augustocrmattos/PQDB-Hardware/PQDB-Mini-HW-Kicad/Fabricação/BOM.pdf

Reference | Value | Footprint
R406 | Resistor 220 Ohm 5% SMD | 0805
R312 | Resistor 10K 5% SMD | 0805
R403 | Resistor 10K 5% SMD | 0805
R404 | Resistor 10K 5% SMD | 0805
R402 | Resistor 10K 5% SMD | 0805
R201 | Resistor 10K 5% SMD | 0805
R311 | Resistor 10K 5% SMD | 0805
R310 | Resistor 10K 5% SMD | 0805
R309 | Resistor 10K 5% SMD | 0805
R202 | Resistor 10K 5% SMD | 0805
R401 | Resistor 10K 5% SMD | 0805
R102 | Resistor 10K 5% SMD | 0805
R701 | Resistor 10K 5% SMD | 0805
R702 | Resistor 10K 5% SMD | 0805
R101 | Resistor 10K 5% SMD | 0805
R405 | Resistor 10K 5% SMD | 0805
R703 | Resistor 10K 5% SMD | 0805
C701 | Capacitor cerâmico 25V 10nF SMD | 0805
R304 | Resistor 1k 5% SMD | 0805
R303 | Resistor 1k 5% SMD | 0805
R302 | Resistor 1k 5% SMD | 0805
R301 | Resistor 1k 5% SMD | 0805
R308 | Resistor 1k 5% SMD | 0805
R307 | Resistor 1k 5% SMD | 0805
R306 | Resistor 1k 5% SMD | 0805
R305 | Resistor 1k 5% SMD | 0805
R501 | Resistor 1k 5% SMD | 0805
R502 | Resistor 1k 5% SMD | 0805
R503 | Resistor 1k 5% SMD | 0805
R103 | Resistor 1k 5% SMD | 0805
R104 | Resistor 1k 5% SMD | 0805
R105 | Resistor 1k 5% SMD | 0805
R106 | Resistor 1k 5% SMD | 0805
X701 | Cristal Axial 32,768 KHz | TC2x6
U401 | Display Nokia 5110
U601 | 74HC595 | SOIC-16
RGB501 | LED RGB 5mm | 4 Pinos
Q304 | BC847 | SOT-23
Q303 | BC847 | SOT-23
Q302 | BC847 | SOT-23
Q301 | BC847 | SOT-23
Q201 | BC847 | SOT-23
Q101 | BC847 | SOT-23
Q102 | BC847 | SOT-23
SW104 | Chave Tactil 6x6x4,3 180 graus 4 Terminais PTH | 6x6x4,3mm
SW106 | Chave Tactil 6x6x4,3 180 graus 4 Terminais PTH | 6x6x4,3mm
SW108 | Chave Tactil 6x6x4,3 180 graus 4 Terminais PTH | 6x6x4,3mm
SW110 | Chave Tactil 6x6x4,3 180 graus 4 Terminais PTH | 6x6x4,3mm
SW102 | Chave Tactil 6x6x4,3 180 graus 4 Terminais PTH | 6x6x4,3mm

SW103 | Chave Tactil 6x6x4,3 180 graus 4 Terminais PTH | 6x6x4,3mm
SW105 | Chave Tactil 6x6x4,3 180 graus 4 Terminais PTH | 6x6x4,3mm
SW107 | Chave Tactil 6x6x4,3 180 graus 4 Terminais PTH | 6x6x4,3mm
SW109 | Chave Tactil 6x6x4,3 180 graus 4 Terminais PTH | 6x6x4,3mm
SW101 | Chave Tactil 6x6x4,3 180 graus 4 Terminais PTH | 6x6x4,3mm
BZ201 | Buzzer 5V | Espaçamento 7,6mm
D102 | LL4148 | MiniMELF
D104 | LL4148 | MiniMELF
D106 | LL4148 | MiniMELF
D108 | LL4148 | MiniMELF
D110 | LL4148 | MiniMELF
D101 | LL4148 | MiniMELF
D103 | LL4148 | MiniMELF
D105 | LL4148 | MiniMELF
D107 | LL4148 | MiniMELF
D109 | LL4148 | MiniMELF
U701 | DS1307Z | SOIC-8
U301 | Display 7 segmentos 4 digitos KW4-361
LDR201 | LDR 5mm 2 terminais
U201 | LM35 | TO-92
RV201 | Potenciômetro duplo 10K | Espaçamento 5mm
RV202 | Potenciômetro duplo 10K | Espaçamento 5mm
SHIELD801 | Barra de pinos 1x40 20mm | Espaçamento 2,54mm
