augustocrmattos/PQDB-Hardware/PQDB-HW-Kicad/fabricação/BOM.pdf

Reference | Value | Footprint
R312 | Resistor 1/8W 10K PTH | CR25
R201 | Resistor 1/8W 10K PTH | CR25
R311 | Resistor 1/8W 10K PTH | CR25
R310 | Resistor 1/8W 10K PTH | CR25
R309 | Resistor 1/8W 10K PTH | CR25
R202 | Resistor 1/8W 10K PTH | CR25
R102 | Resistor 1/8W 10K PTH | CR25
R701 | Resistor 1/8W 10K PTH | CR25
R702 | Resistor 1/8W 10K PTH | CR25
R101 | Resistor 1/8W 10K PTH | CR25
C701 | Capacitor cerâmico 25V 10nF PTH | 5mm
R407 | Resistor 1/8W 1K PTH | CR25
R408 | Resistor 1/8W 1K PTH | CR25
R406 | Resistor 1/8W 1K PTH | CR25
R304 | Resistor 1/8W 1K PTH | CR25
R303 | Resistor 1/8W 1K PTH | CR25
R302 | Resistor 1/8W 1K PTH | CR25
R301 | Resistor 1/8W 1K PTH | CR25
R308 | Resistor 1/8W 1K PTH | CR25
R307 | Resistor 1/8W 1K PTH | CR25
R306 | Resistor 1/8W 1K PTH | CR25
R305 | Resistor 1/8W 1K PTH | CR25
R401 | Resistor 1/8W 1K PTH | CR25
R501 | Resistor 1/8W 1K PTH | CR25
R502 | Resistor 1/8W 1K PTH | CR25
R503 | Resistor 1/8W 1K PTH | CR25
R103 | Resistor 1/8W 1K PTH | CR25
R105 | Resistor 1/8W 1K PTH | CR25
R106 | Resistor 1/8W 1K PTH | CR25
R104 | Resistor 1/8W 1K PTH | CR25
X701 | Cristal Axial 32,768 KHz | TC2x6
U601 | 74HC595 | DIP-16
RGB501 | LED RGB 5mm | 4 Pinos
Q304 | BC547 | TO-92
Q303 | BC547 | TO-92
Q302 | BC547 | TO-92
Q301 | BC547 | TO-92
Q201 | BC547 | TO-92
Q101 | BC547 | TO-92
Q102 | BC547 | TO-92
SW103 | Chave Tactil 6x6x4,3 180 graus 4 Terminais PTH | 6x6x4,3mm
SW105 | Chave Tactil 6x6x4,3 180 graus 4 Terminais PTH | 6x6x4,3mm
SW107 | Chave Tactil 6x6x4,3 180 graus 4 Terminais PTH | 6x6x4,3mm
SW109 | Chave Tactil 6x6x4,3 180 graus 4 Terminais PTH | 6x6x4,3mm
SW101 | Chave Tactil 6x6x4,3 180 graus 4 Terminais PTH | 6x6x4,3mm
SW104 | Chave Tactil 6x6x4,3 180 graus 4 Terminais PTH | 6x6x4,3mm
SW106 | Chave Tactil 6x6x4,3 180 graus 4 Terminais PTH | 6x6x4,3mm
SW108 | Chave Tactil 6x6x4,3 180 graus 4 Terminais PTH | 6x6x4,3mm
SW110 | Chave Tactil 6x6x4,3 180 graus 4 Terminais PTH | 6x6x4,3mm

SW102 | Chave Tactil 6x6x4,3 180 graus 4 Terminais PTH | 6x6x4,3mm
BZ201 | Buzzer 5V | Espaçamento 7,6mm
BT701 | Suporte para bateria CR2032
D101 | 1N4148 | DO-35
D103 | 1N4148 | DO-35
D105 | 1N4148 | DO-35
D107 | 1N4148 | DO-35
D109 | 1N4148 | DO-35
D102 | 1N4148 | DO-35
D104 | 1N4148 | DO-35
D106 | 1N4148 | DO-35
D108 | 1N4148 | DO-35
D110 | 1N4148 | DO-35
U401 | DISPLAY LCD JHD162A
U701 | DS1307Z | DIP-8
U301 | Display 7 segmentos 4 digitos KW4-361
LDR201 | LDR 5mm 2 terminais
U201 | LM35 | TO-92
RV401 | Potenciômetro duplo 10K | Espaçamento 5mm
RV201 | Potenciômetro duplo 10K | Espaçamento 5mm
SHIELD801 | Barra de pinos 1x40 20mm | Espaçamento 2,54mm
