augustocrmattos/PQDB-Hardware/Montagem Mini SMD.pdf

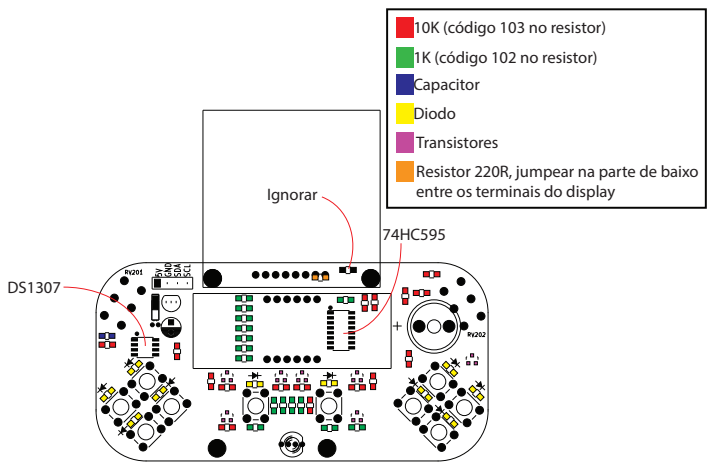
[picture p37: page 1]
Ignorar; entre os terminais do display

10K (código 103 no resistor)
1K (código 102 no resistor)
Capacitor
Diodo
Transistores
Resistor 220R, jumpear na parte de baixo
