augustocrmattos/PQDB-Hardware/PQDB-HW-Kicad/fabricação/Base-F.SilkS.pdf

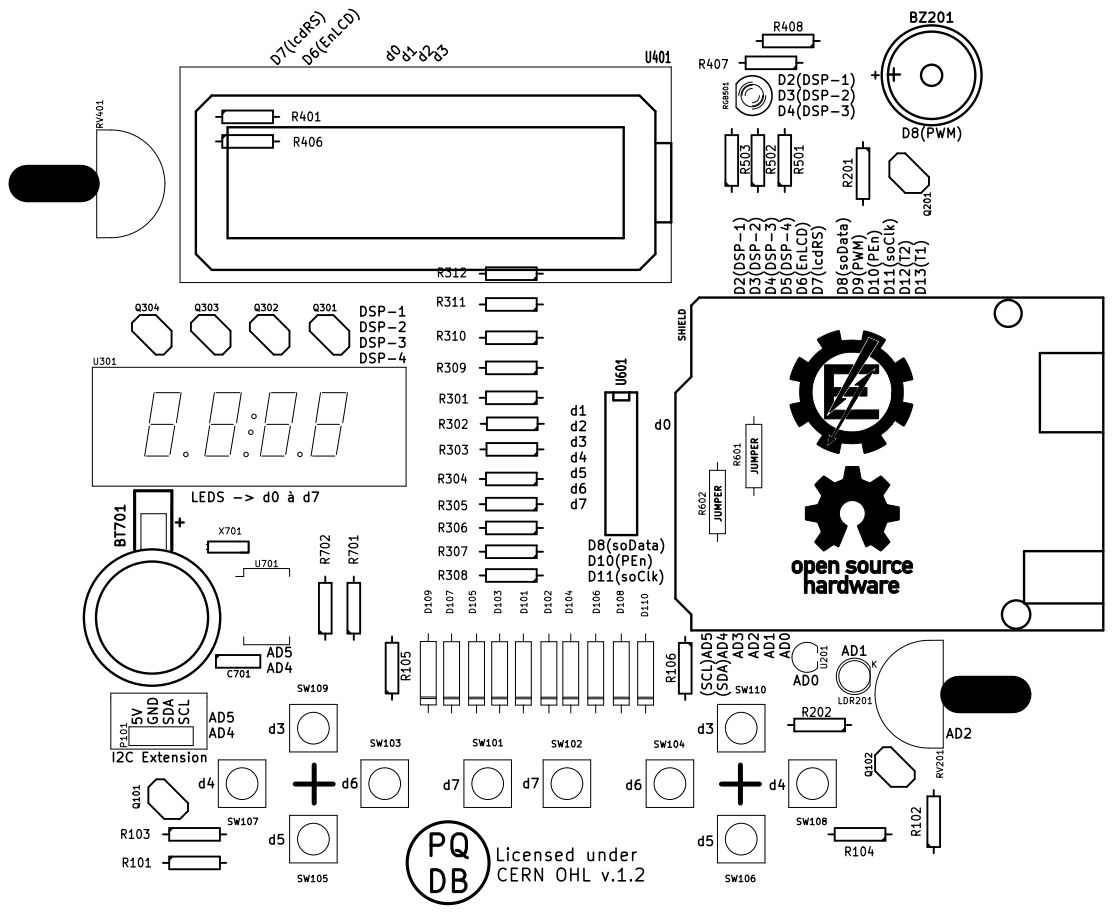
[picture p38: page 1]
