augustocrmattos/PQDB-Hardware/PQDB-Mini-HW-Kicad/Fabricação/Base-B.Cu.pdf

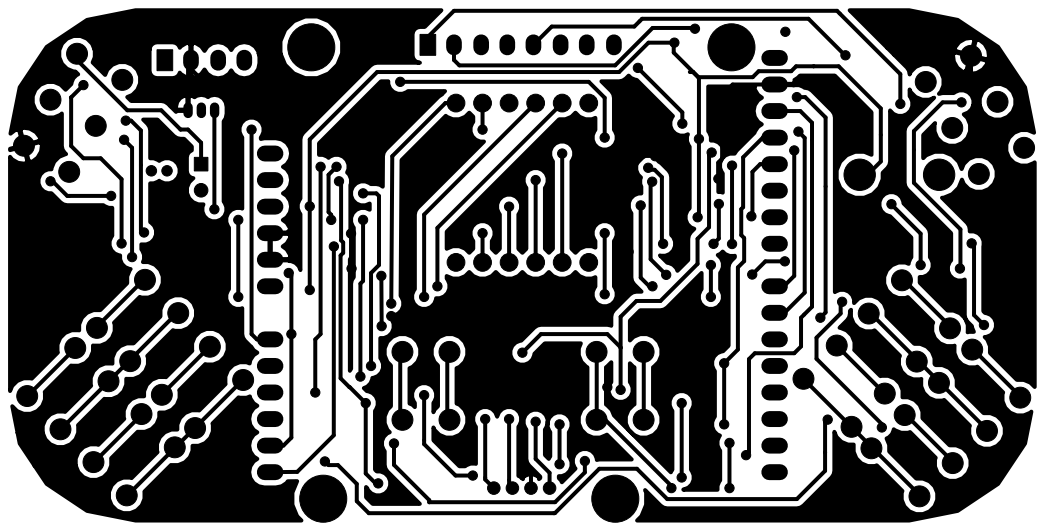
[picture p39: page 1]
