augustocrmattos/PQDB-Hardware/PQDB-Mini-HW-Kicad/Fabricação/Base-B.Mask.pdf

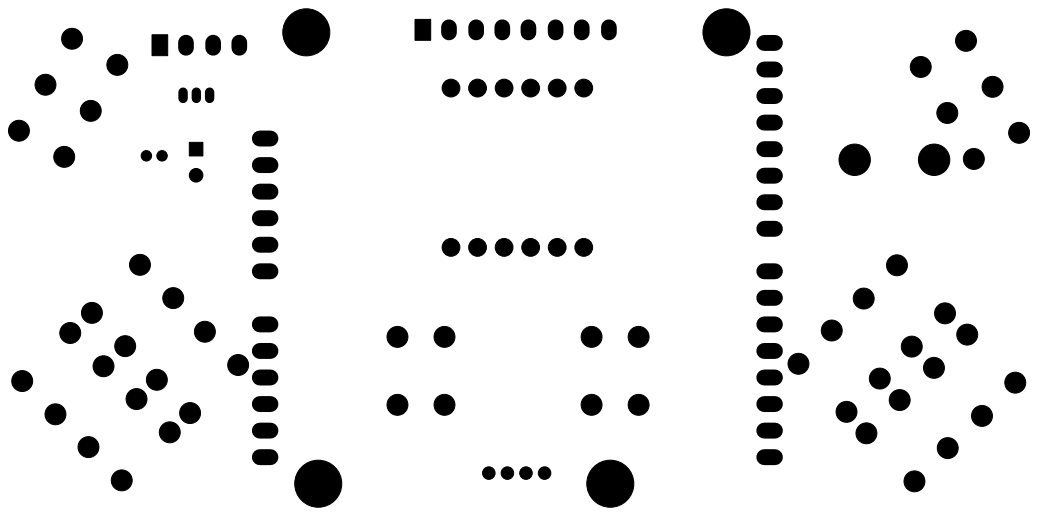
[picture p40: page 1]
