augustocrmattos/PQDB-Hardware/PQDB-Mini-HW-Kicad/Fabricação/Base-Edge.Cuts.pdf

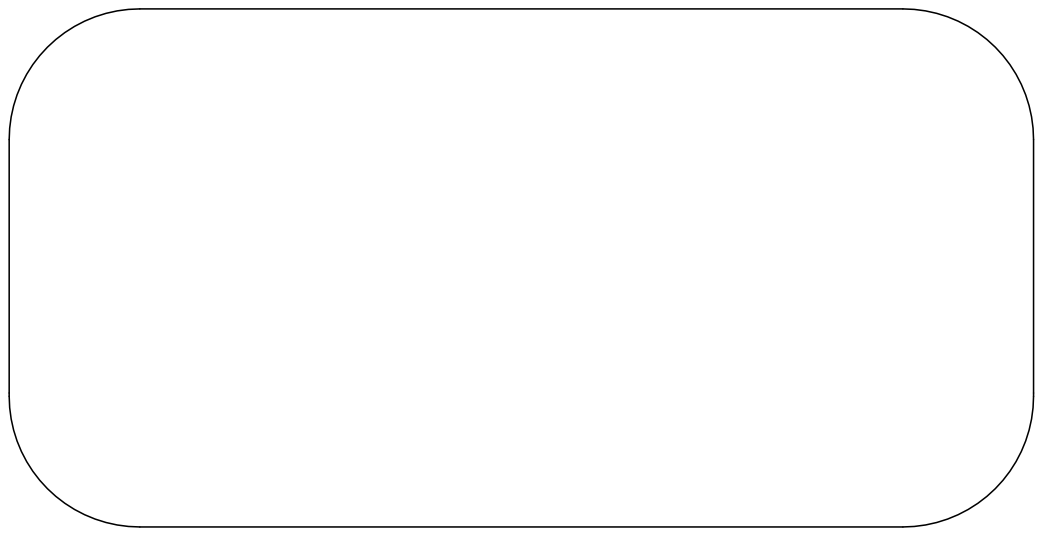
[picture p41: page 1]
