augustocrmattos/PQDB-Hardware/PQDB-Mini-HW-Kicad/Fabricação/Base-F.Cu.pdf

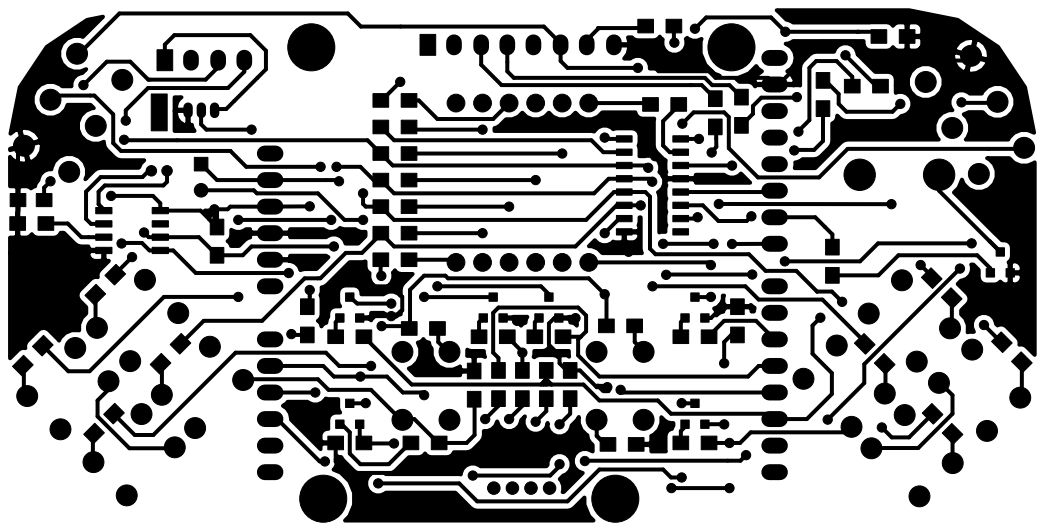
[picture p42: page 1]
