augustocrmattos/PQDB-Hardware/PQDB-Mini-HW-Kicad/Fabricação/Base-F.Mask.pdf

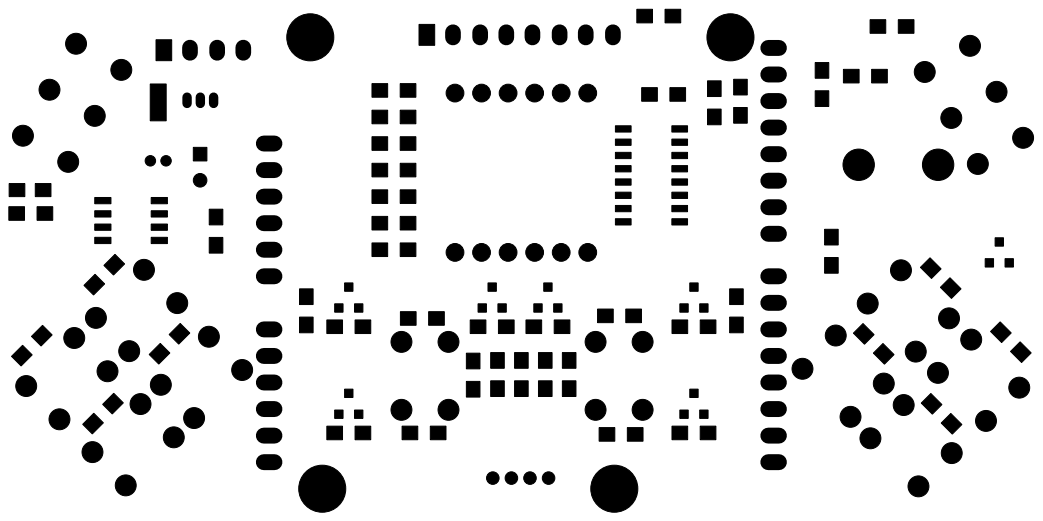
[picture p43: page 1]
