augustocrmattos/PQDB-Hardware/PQDB-Mini-HW-Kicad/Fabricação/Base-F.SilkS.pdf

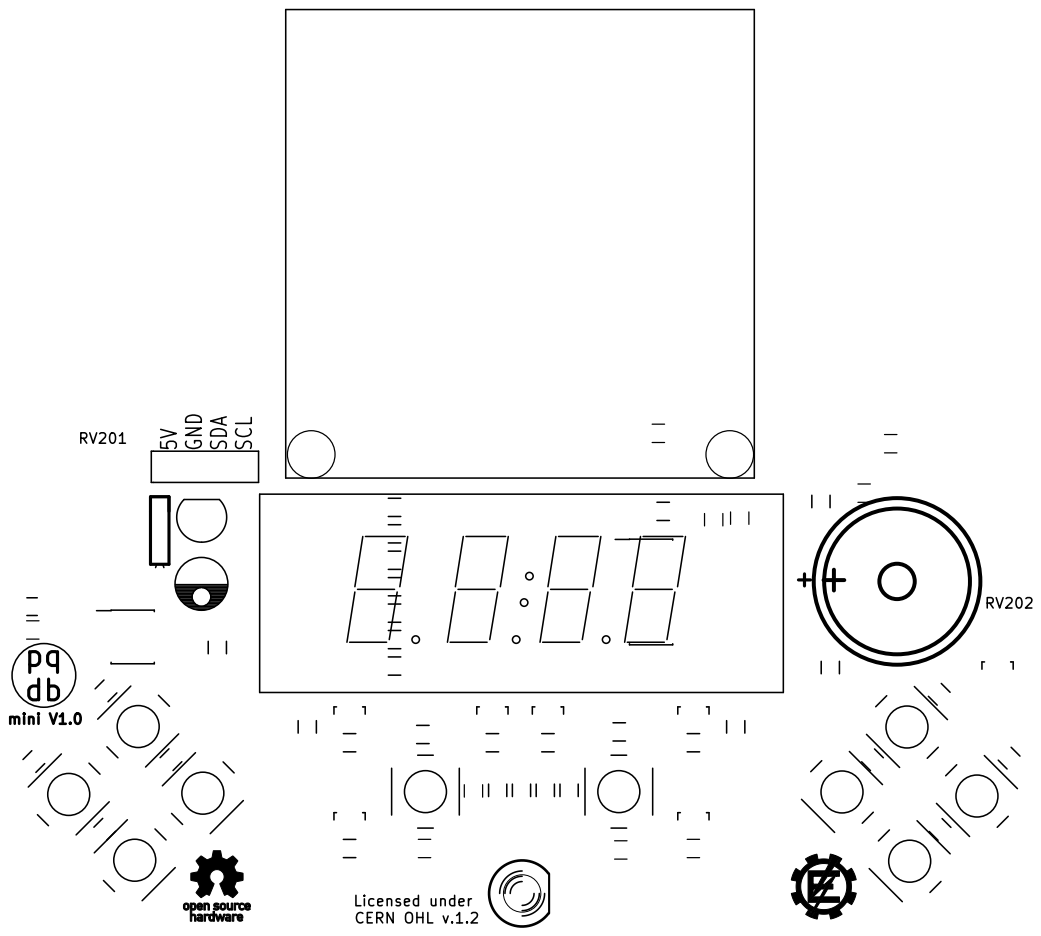
[picture p44: page 1]

Licensed under CERN OHL v.1.2 mini V1.0pq
