augustocrmattos/PQDB-Hardware/PQDB-HW-Kicad/fabricação/Base-B.Cu.pdf

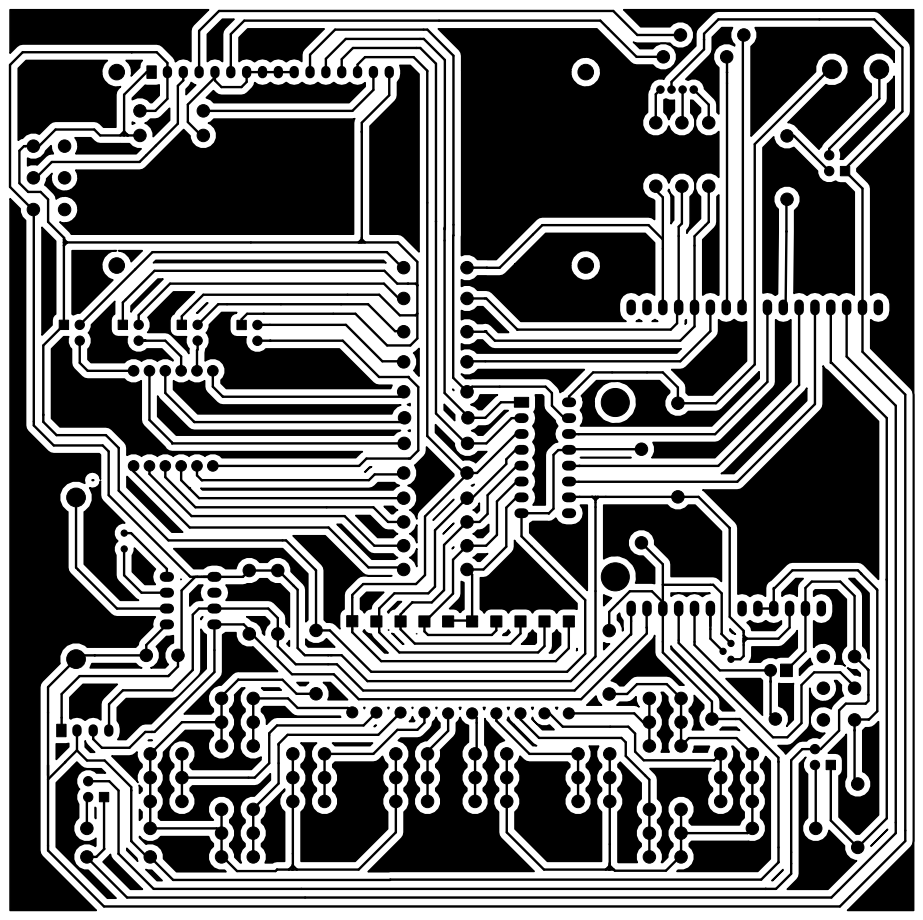
[picture p45: page 1]
