augustocrmattos/PQDB-Hardware/PQDB-HW-Kicad/fabricação/Base-B.Mask.pdf

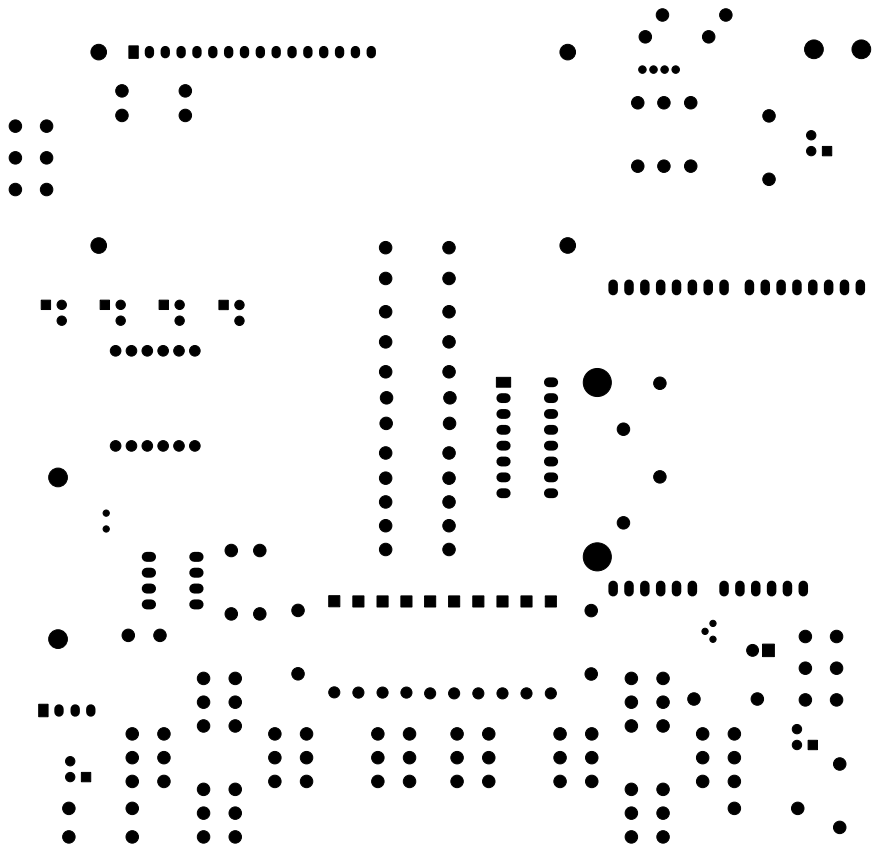
[picture p46: page 1]
