augustocrmattos/PQDB-Hardware/PQDB-Mini-HW-Kicad/Fabricação/Base.pdf

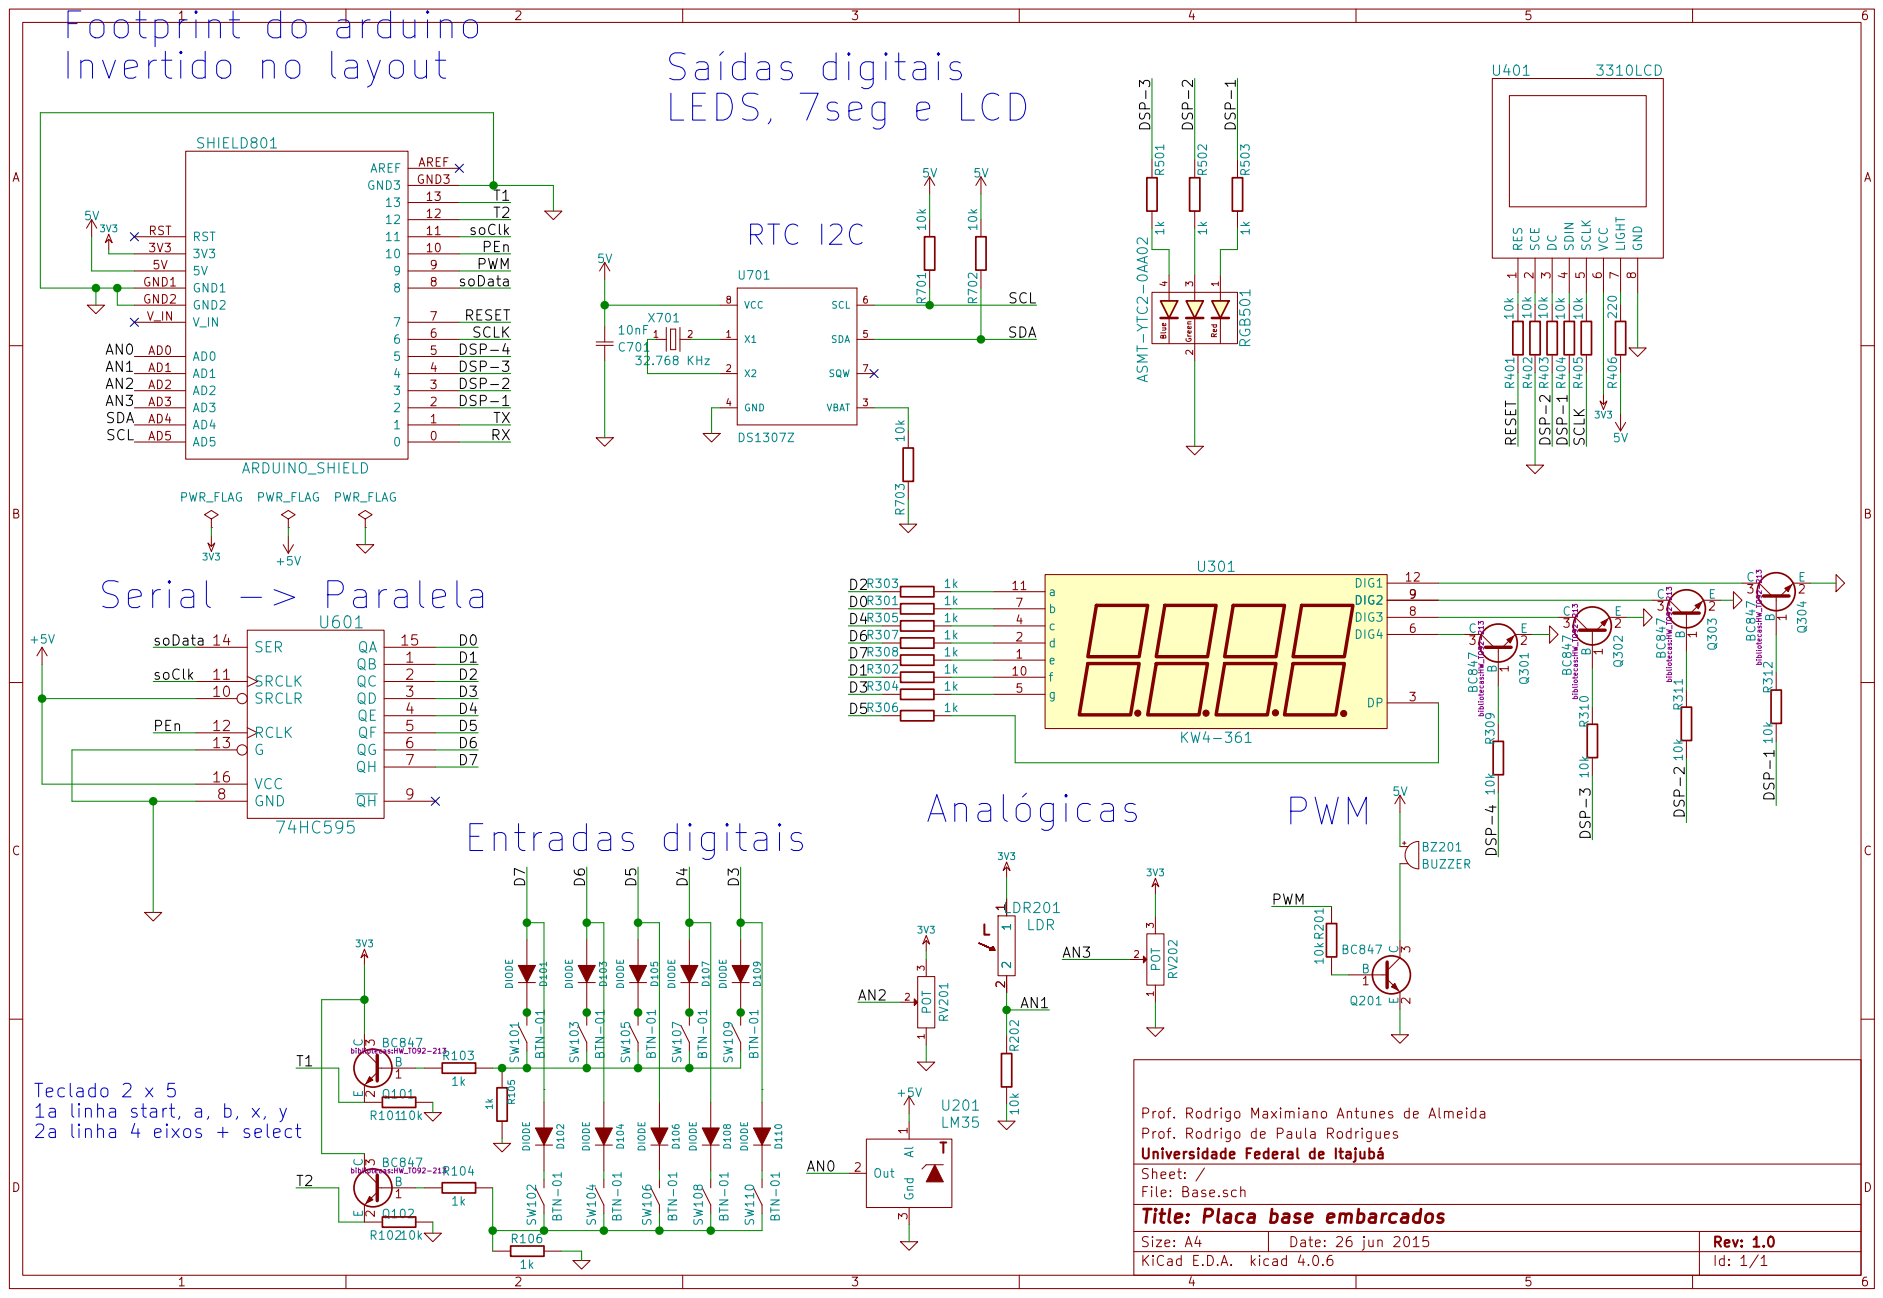
[picture p47: page 1]

Prof. Rodrigo Maximiano Antunes de Almeida
Prof. Rodrigo de Paula Rodrigues
File: Base.sch Sheet: / Universidade Federal de Itajubá

Id: 1/1 Title: Placa base embarcados
