augustocrmattos/PQDB-Hardware/PQDB-Mini-HW-Kicad/Esquemático.pdf

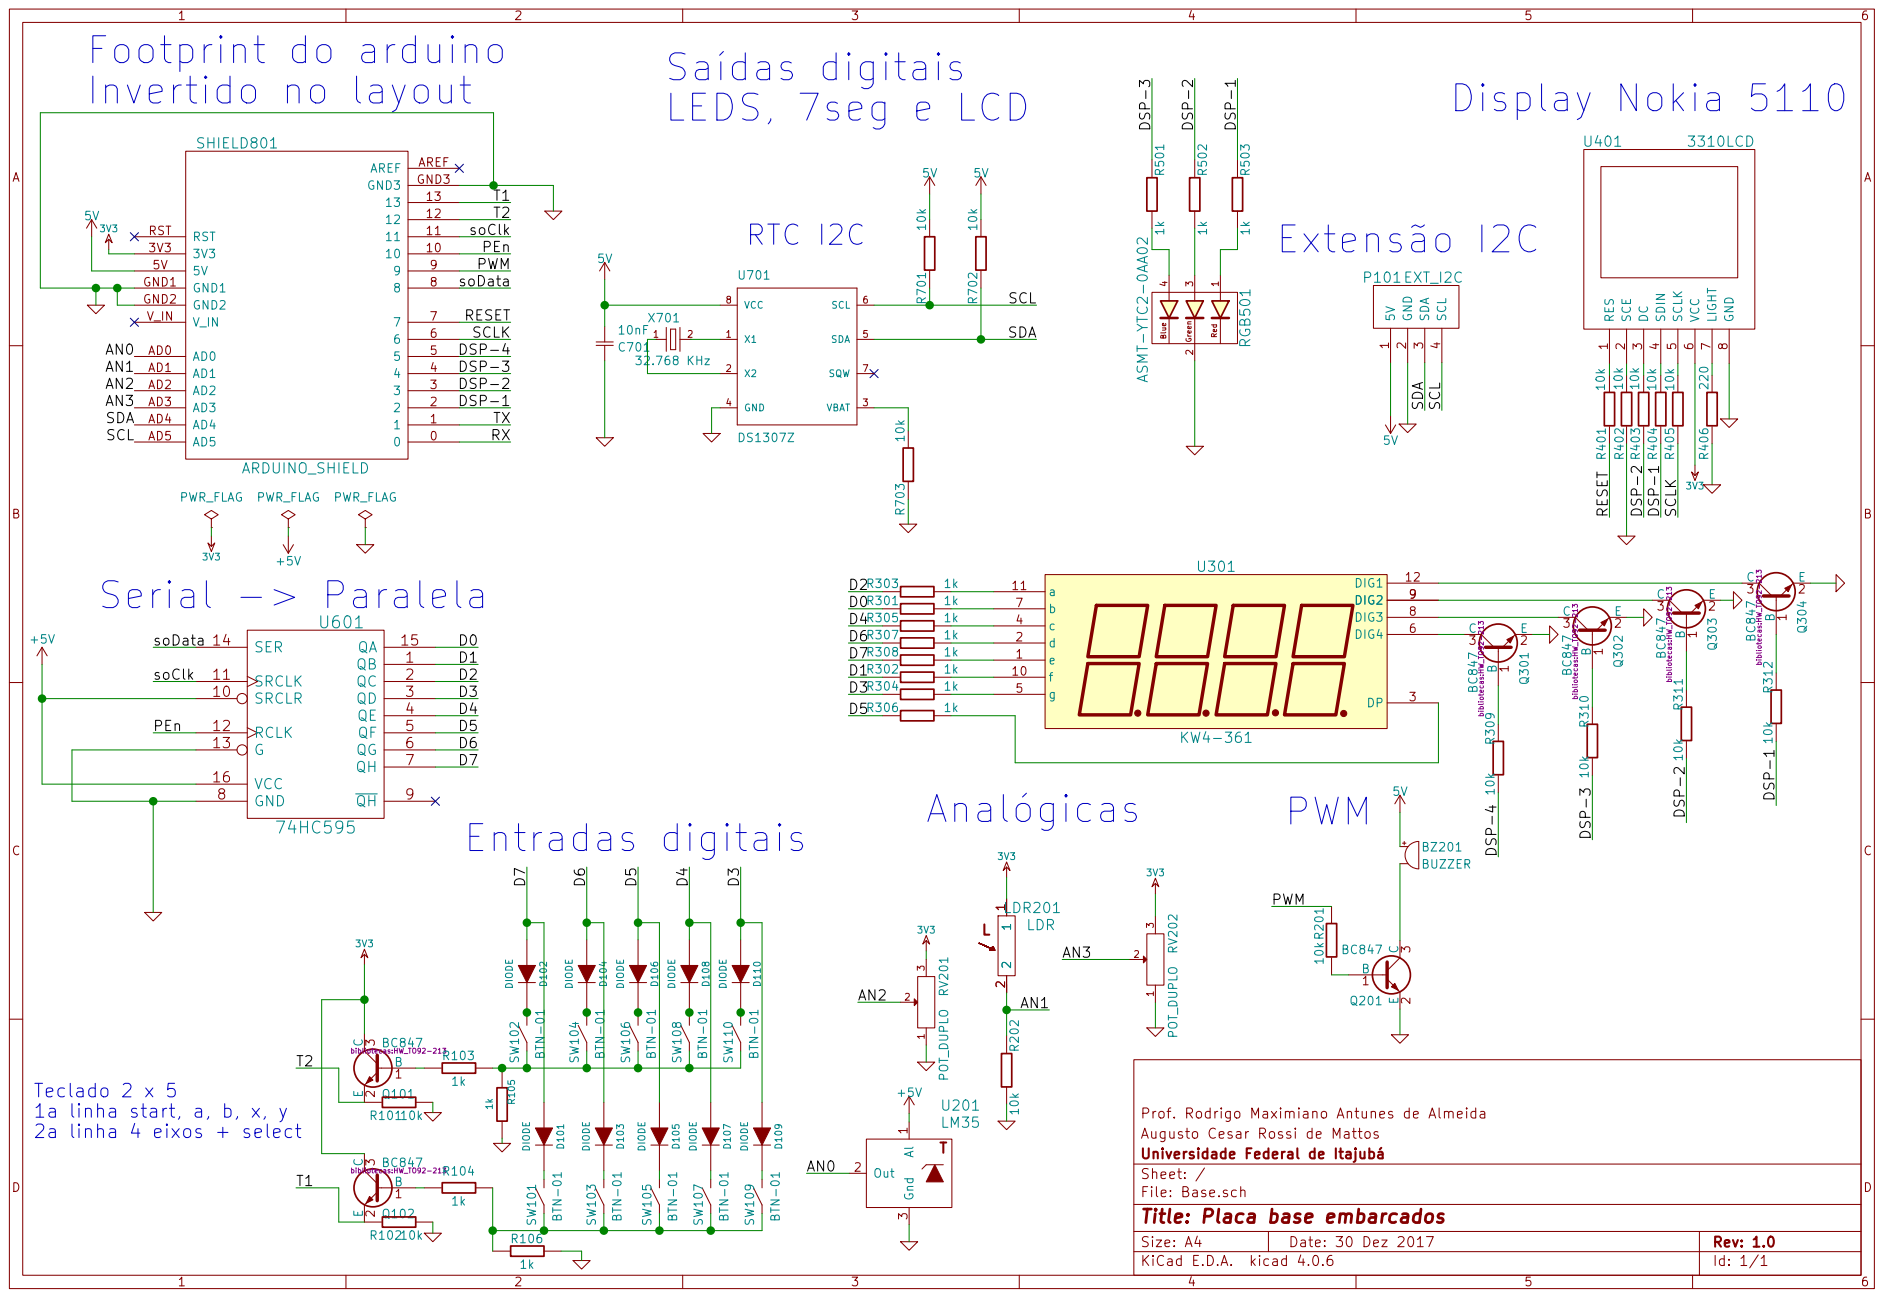
[picture p48: page 1]

Prof. Rodrigo Maximiano Antunes de Almeida
Augusto Cesar Rossi de Mattos
File: Base.sch Sheet: / Universidade Federal de Itajubá

Id: 1/1 Title: Placa base embarcados
