augustocrmattos/PQDB-Hardware/PQDB-HW-Kicad/Base.kicad_pcb

## KiCad design PQDB-HW-Kicad/Base.kicad_pcb (2018-05-15)

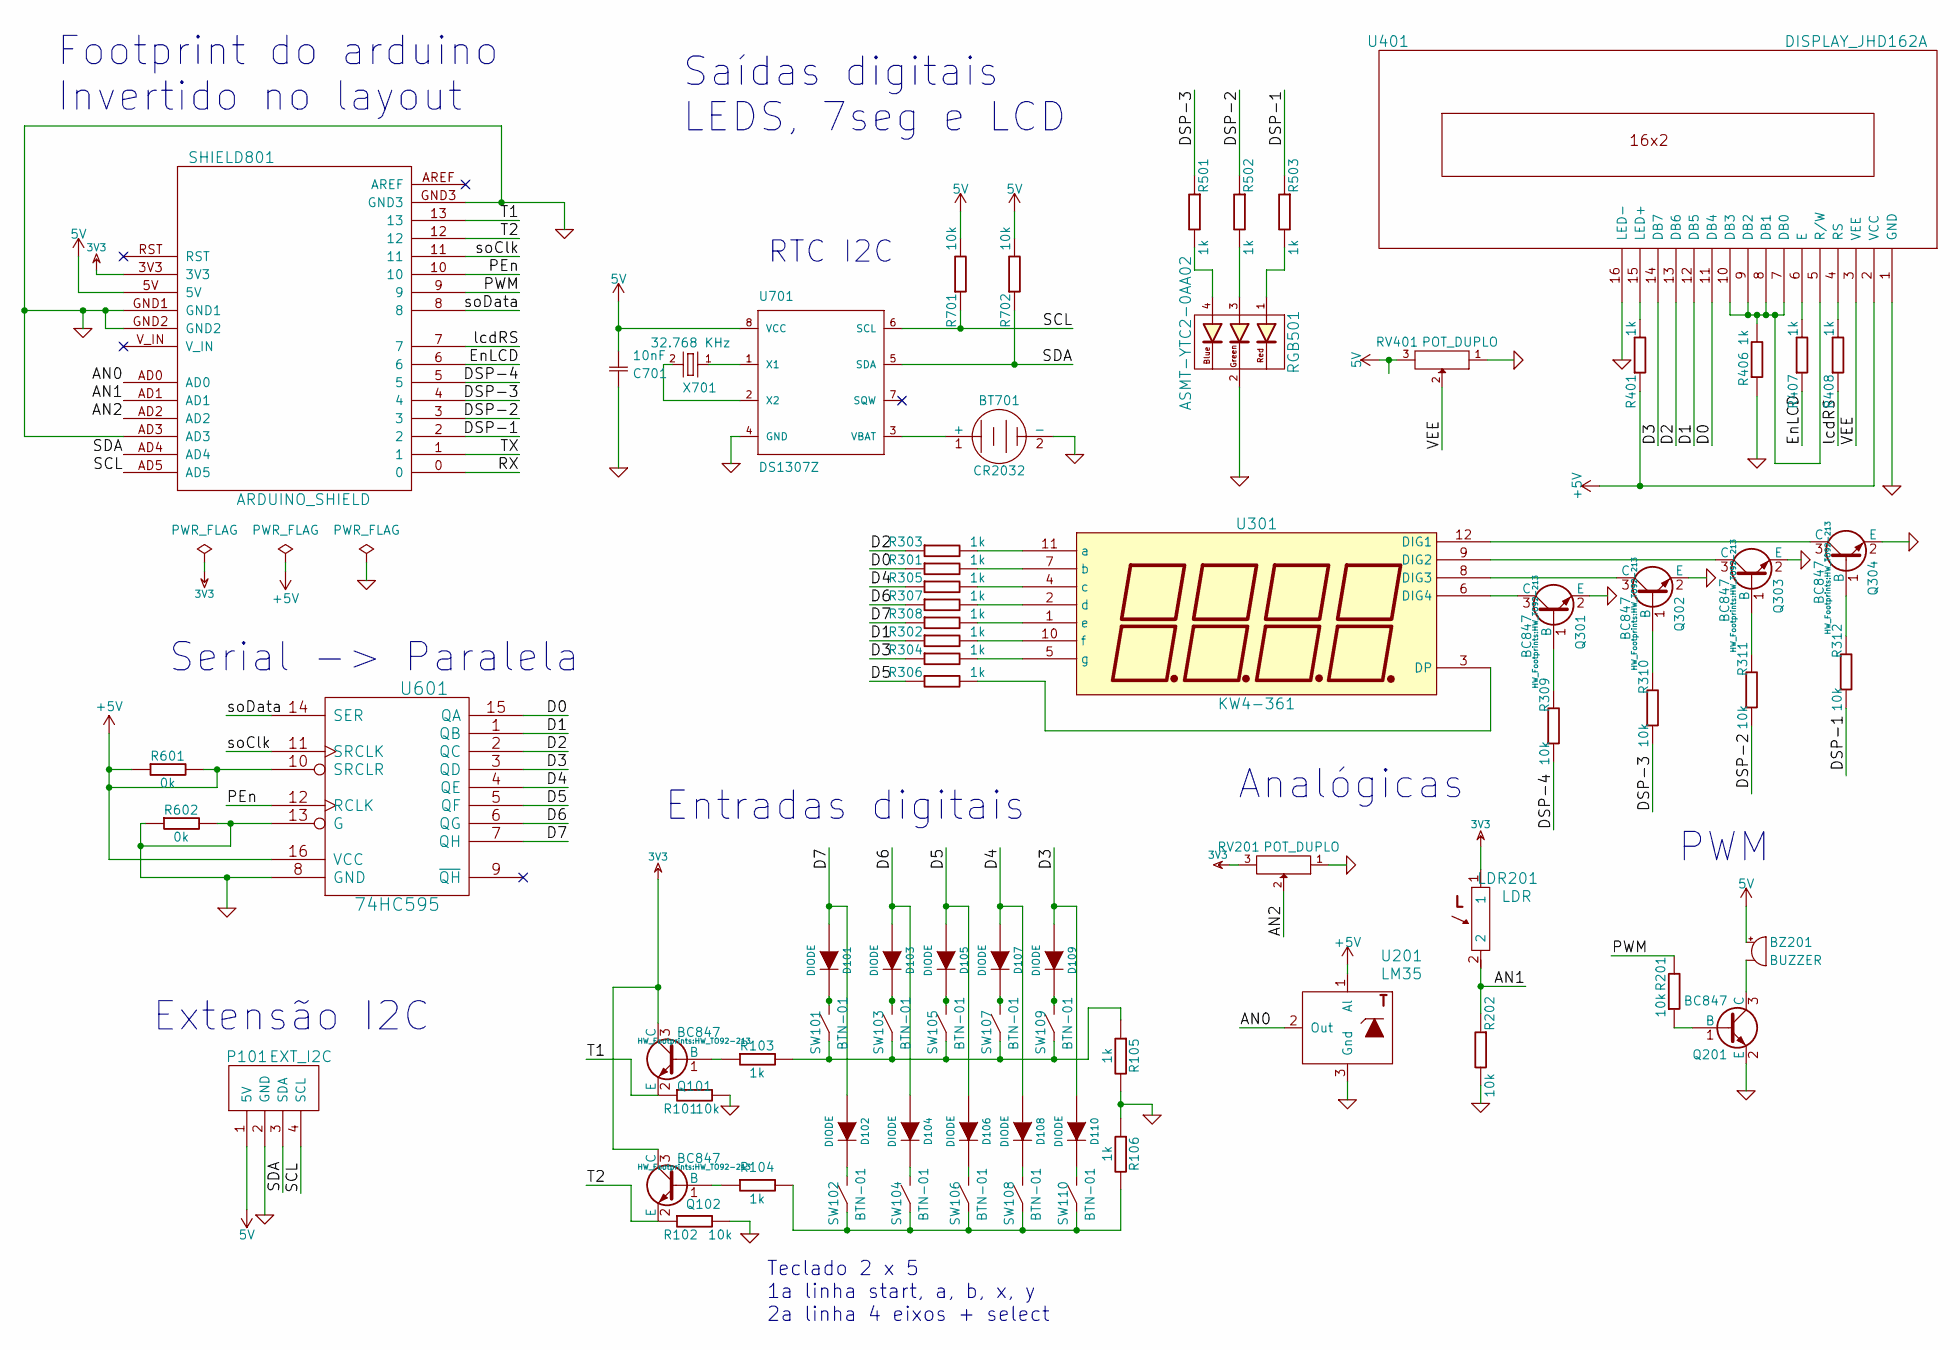
[picture p49: schematic Base.sch, pdqdb v1.0]

Parts:
BT701: CR2032; HW_CR2032H
BZ201: BUZZER; HW_Buzzer
C701: 10nF; HW_CAPACITOR
D101, D102, D103, D104, D105, D106, D107, D108, D109, D110: DIODE; D5
LDR201: LDR; HW_LDR
P101: EXT_I2C
Q101, Q102, Q201, Q301, Q302, Q303, Q304: BC847; HW_TO92-213
R101, R102, R201, R202, R309, R310, R311, R312, R701, R702: 10k; HW_Resistor
R103, R104, R105, R106, R301, R302, R303, R304, R305, R306, R307, R308, R401, R406, R407, R408, R501, R502, R503: 1k; HW_Resistor
R601, R602: 0k; Resistor_Horizontal_RM15mm
RGB501: ASMT-YTC2-0AA02; LED-5MM
RV201, RV401: POT_DUPLO; HW_Potenciometro_2_Duplo
SHIELD801: ARDUINO_SHIELD; ARDUINO_SHIELD_2
SW101, SW102, SW103, SW104, SW105, SW106, SW107, SW108, SW109, SW110: BTN-01; HW_Switch_tactil_adaptada
U201: LM35; TO-92_Molded_Narrow_Reverse
U301: KW4-361; HW_Disp_7seg_4dig
U401: DISPLAY_JHD162A; HW_LCD
U601: 74HC595; HW_DIP-16__300_ELL
U701: DS1307Z; DIP-8_W7.62mm_LongPads
X701: 32.768 KHz; Crystal_Round_Horizontal_2mm

Connections:
3V3: LDR201.1, Q101.3 (C), Q102.3 (C), RV201.3, SHIELD801.3V3
/AN0: SHIELD801.AD0, U201.2 (Out)
/AN1: LDR201.2, R202.1, SHIELD801.AD1
/AN2: RV201.2, SHIELD801.AD2
/D0: R301.1, U401.11 (DB4), U601.15 (QA)
/D1: R302.1, U401.12 (DB5), U601.1 (QB)
/D2: R303.1, U401.13 (DB6), U601.2 (QC)
/D3: D109.1 (A), D110.1 (A), R304.1, U401.14 (DB7), U601.3 (QD)
/D4: D107.1 (A), D108.1 (A), R305.1, U601.4 (QE)
/D5: D105.1 (A), D106.1 (A), R306.1, U601.5 (QF)
/D6: D103.1 (A), D104.1 (A), R307.1, U601.6 (QG)
/D7: D101.1 (A), D102.1 (A), R308.1, U601.7 (QH)
/DSP-1: R312.1, R503.1, SHIELD801.2
/DSP-2: R311.1, R502.1, SHIELD801.3
/DSP-3: R310.1, R501.1, SHIELD801.4
/DSP-4: R309.1, SHIELD801.5
/EnLCD: R407.1, SHIELD801.6
/PEn: SHIELD801.10, U601.12 (RCLK)
/PWM: R201.2, SHIELD801.9
/RX: SHIELD801.0
/SCL: P101.4 (SCL), R701.1, SHIELD801.AD5, U701.6 (SCL)
/SDA: P101.3 (SDA), R702.1, SHIELD801.AD4, U701.5 (SDA)
/T1: Q101.2 (E), R101.1, SHIELD801.13
/T2: Q102.2 (E), R102.1, SHIELD801.12
/TX: SHIELD801.1
/VEE: RV401.2, U401.3 (VEE)
/lcdRS: R408.1, SHIELD801.7
/soClk: SHIELD801.11, U601.11 (SRCLK)
/soData: SHIELD801.8, U601.14 (SER)
GND: BT701.2 (-), C701.1, P101.2 (GND), Q201.2 (E), Q301.2 (E), Q302.2 (E), Q303.2 (E), Q304.2 (E), R101.2, R102.2, R105.2, R106.1, R202.2, R406.1, R602.1, R602.2, RGB501.2 (KG), RV201.1, RV401.1, SHIELD801.AD3, SHIELD801.GND1, SHIELD801.GND2, SHIELD801.GND3, U201.3 (Gnd), U401.1 (GND), U401.16 (LED-), U601.8 (GND), U601.13 (G), U701.4 (GND)
unnamed: BT701.1 (+), U701.3 (VBAT)
unnamed: BZ201.2, Q201.3 (C)
unnamed: D101.2 (K), SW101.2
unnamed: D102.2 (K), SW102.2
unnamed: D103.2 (K), SW103.2
unnamed: D104.2 (K), SW104.2
unnamed: D105.2 (K), SW105.2
unnamed: D106.2 (K), SW106.2
unnamed: D107.2 (K), SW107.2
unnamed: D108.2 (K), SW108.2
unnamed: D109.2 (K), SW109.2
unnamed: D110.2 (K), SW110.2
unnamed: Q101.1 (B), R103.1
unnamed: Q102.1 (B), R104.1
unnamed: Q201.1 (B), R201.1
unnamed: Q301.1 (B), R309.2
unnamed: Q301.3 (C), U301.6 (DIG4)
unnamed: Q302.1 (B), R310.2
unnamed: Q302.3 (C), U301.8 (DIG3)
unnamed: Q303.1 (B), R311.2
unnamed: Q303.3 (C), U301.9 (DIG2)
unnamed: Q304.1 (B), R312.2
unnamed: Q304.3 (C), U301.12 (DIG1)
unnamed: R103.2, R105.1, SW101.1, SW103.1, SW105.1, SW107.1, SW109.1
unnamed: R104.2, R106.2, SW102.1, SW104.1, SW106.1, SW108.1, SW110.1
unnamed: R301.2, U301.7 (b)
unnamed: R302.2, U301.10 (f)
unnamed: R303.2, U301.11 (a)
unnamed: R304.2, U301.5 (g)
unnamed: R305.2, U301.4 (c)
unnamed: R306.2, U301.3 (DP)
unnamed: R307.2, U301.2 (d)
unnamed: R308.2, U301.1 (e)
unnamed: R401.2, U401.15 (LED+)
unnamed: R406.2, U401.5 (R/W), U401.7 (DB0), U401.8 (DB1), U401.9 (DB2), U401.10 (DB3)
unnamed: R407.2, U401.6 (E)
unnamed: R408.2, U401.4 (RS)
unnamed: R501.2, RGB501.4 (AB)
unnamed: R502.2, RGB501.3 (AG)
unnamed: R503.2, RGB501.1 (AR)
unnamed: U701.1 (X1), X701.1
unnamed: U701.2 (X2), X701.2

Notes on the sheet:
RTC I2C
Saídas digitais LEDS, 7seg e LCD
Teclado 2 x 5 1a linha start, a, b, x, y 2a linha 4 eixos + select
Analógicas
PWM
Serial -> Paralela
Footprint do arduino Invertido no layout
Entradas digitais
Extensão I2C

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
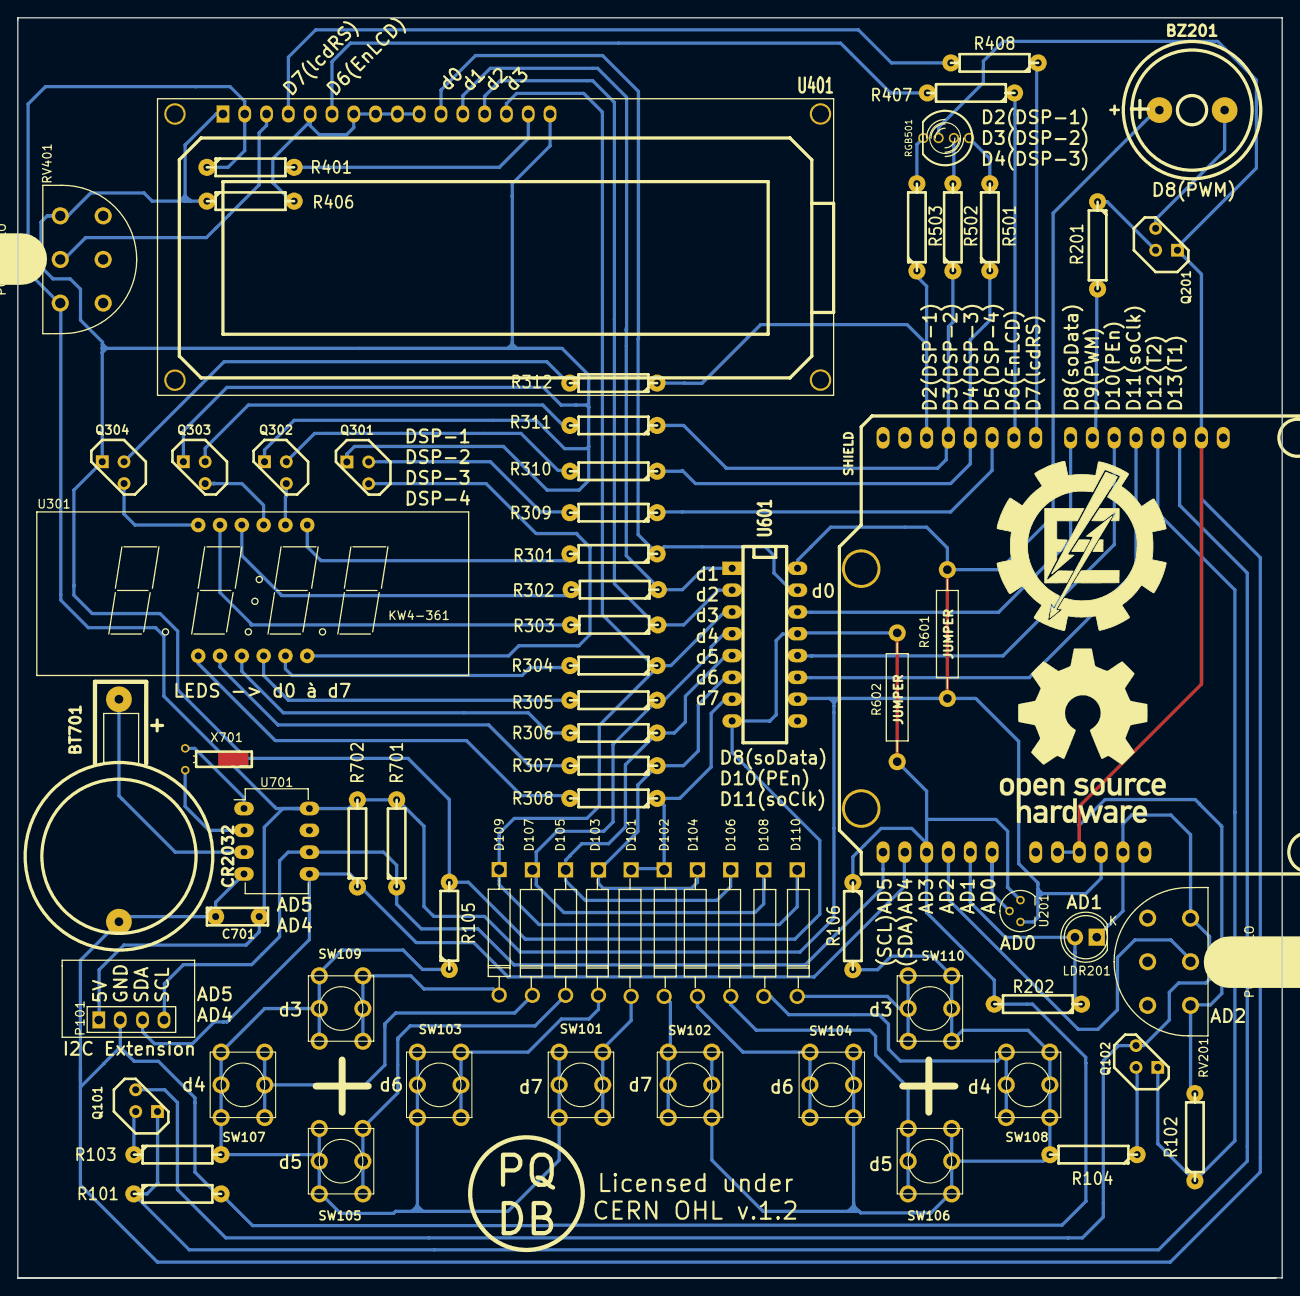
[picture p50: board Base.kicad_pcb from above]

Board: 2 copper layers, 147.2 x 146.8 mm, 73 parts (1 on the bottom side), 71 nets.
